KarthikL1729/EW-2-project-1/README.md

# Electronics Workshop - 2

## Project 1 - Audio Amplifier

Circuit design for a fully functional four stage audio amplifier as per required specifications.
