KarthikL1729/EW-2-project-1/powerampstage.png

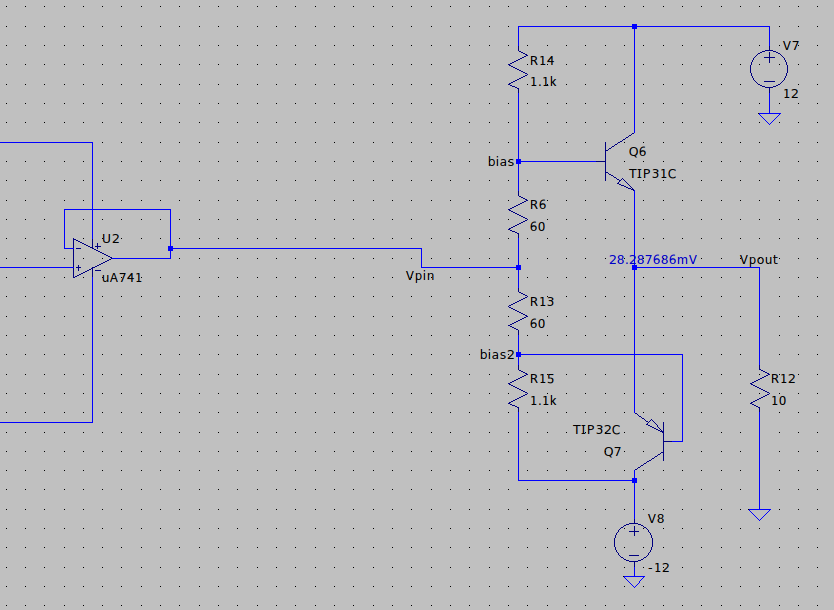
powerampstage.png
