KarthikL1729/EW-2-project-1/ampsave.asc

C1: cap; 47n
C2: cap; 10n
C3: cap; 10µ
C4: cap; 10µ
C12: cap; 10µ
C13: cap; 100µ
D1: diode; 1N4148
D2: diode; 1N4148
Q1: npn; 2N3904
Q2: npn; 2N3904
Q3: npn; 2N3904
Q6: npn; TIP41
Q7: pnp; TIP42
Q8: npn; 2N3904
Q9: npn; 2N3904
Q10: npn; 2N3904
Q11: npn; 2N3904
R1: res; 10k
R2: res; 4.7k
R3: res; 78k
R4: res; 10k
R5: res; 10k
R7: res; 210k
R8: res; 390
R9: res; 10k
R10: res; 165k
R11: res; 9.1k
R12: res; 10
R14: res; 500
R15: res; 500
R16: res; 10k
R17: res; 10k
R18: res; 4k
R19: res; 1k
R20: res; 4k
R21: res; 1k
U1: opamp2; uA741
U2: opamp2; uA741
V1: voltage; 12
V2: voltage; SINE(0 18m 2k); AC 1
V3: voltage; 12
V4: voltage; 12
V5: voltage; SINE(0 10m 2k); AC 1
V6: voltage; -12
V7: voltage; 12
V8: voltage; -12
V9: voltage; -12
V10: voltage; 5
V11: voltage; SINE(0 2m 2k 0 0 180)
V12: voltage; SINE(0 20m 2k)
V13: voltage; 5
V14: voltage; -12
Named nets: 0, col, em, Vpout, Vpin, bias, bias2
.tran 1m
.op 1m
;ac dec 30 1 1G
;tran 10m
.lib uA741.sub
.lib pwrbjt.lib
